umcu7tcoillab/Driverboard/(commit log)

2019-11-21 Changed: Added zener clamping. Small changes.
    [Driverboard_UMCU.csv, Driverboard_UMCU.kicad_pcb, Driverboard_UMCU.sch]
2019-11-21 Changed: starting with malfunction more robust
    [Driverboard_UMCU.kicad_pcb, Driverboard_UMCU.sch, ID_code.sch, SelectToVSwitch.sch]
2019-11-24 Finished v0.1
    [Driverboard_UMCU.kicad_pcb]
2019-11-27 V0.1 ordered. Tidied everything
    [Driverboard_UMCU.kicad_pcb, Driverboard_UMCU.sch, ID_code.sch, Ref_V.sch, SelectToVSwitch.sch]
2019-12-11 Fixed some mistakes of v0.1
    [Driverboard_UMCU.kicad_pcb, Driverboard_UMCU.sch, Ref_V.sch, SelectToVSwitch.sch]
2019-12-19 Fixed: mistakes from v0.1. Added: extra malf pins at Tr connector. Changed: order of pins in TR connector
    [Driverboard_UMCU.kicad_pcb, Driverboard_UMCU.sch, SelectToVSwitch.sch]
2019-12-23 Fixed: better ground paths. Added: license and improved readme.
    [Driverboard_UMCU.csv, Driverboard_UMCU.kicad_pcb, Driverboard_UMCU.sch]
2020-01-07 Changed: Moved some vias. Moved things, for better readability
    [Driverboard_UMCU.kicad_pcb, ID_code.sch]
2020-01-07 Removed: duplicate license file. Fixed: mistake after moved item.
    [Driverboard_UMCU.kicad_pcb]
2020-01-07 Added: local custom made footprints/symbols
    [Driverboard_UMCU.kicad_pcb, Driverboard_UMCU.sch]
2020-01-13 Updated: sheet data. Changed: placed PCB in middle of the sheet
    [Driverboard_UMCU.kicad_pcb, Driverboard_UMCU.sch, ID_code.sch, Ref_V.sch, SelectToVSwitch.sch]
2020-02-26 Changed: Removed unnecessary references in file
    [Driverboard_UMCU.kicad_pcb, Driverboard_UMCU.sch, ID_code.sch, Ref_V.sch, SelectToVSwitch.sch]
2020-03-12 Changed: resistor value
    [SelectToVSwitch.sch]
2020-03-12 Updated: references
    [Driverboard_UMCU.sch, ID_code.sch]
2020-03-12 Changed: voltage ref to use one regulator
    [Driverboard_UMCU.kicad_pcb, Ref_V.sch]
2020-03-13 Updated: zener diode in ID line
    [Driverboard_UMCU.kicad_pcb, Driverboard_UMCU.sch]
2020-03-13 Updated: shunt capacitor
    [ID_code.sch]
2020-03-13 Changed: resistor value for faster switching
    [ID_code.sch]
2020-03-13 Removed: unnecessary C's. Changed: zener diode value in ID line
    [Driverboard_UMCU.kicad_pcb, Driverboard_UMCU.sch]
2020-03-17 Changed: shunt C values
    [Driverboard_UMCU.sch]
2020-03-17 Combined the 2 output connectors into 1
    [Driverboard_UMCU.kicad_pcb, Driverboard_UMCU.sch, ID_code.sch, Ref_V.sch, SelectToVSwitch.sch]
2020-03-18 Changed: small fixes
    [Driverboard_UMCU.kicad_pcb, Driverboard_UMCU.sch]
2020-03-23 Improved: ability to turn off malfunction detection with jumper, previous did not work
    [Driverboard_UMCU.kicad_pcb, Driverboard_UMCU.sch, ID_code.sch]
2020-04-07 switched R22, R23 to be consistent with TR switch part
    [Driverboard_UMCU.kicad_pcb]
2020-04-10 Updated: Worksheet, optimized component values. Added: capacitor on MH to extra speed,
    [Driverboard_UMCU.kicad_pcb, Driverboard_UMCU.sch, ID_code.sch, Ref_V.sch, SelectToVSwitch.sch]
2020-04-17 Optimized component values
    [Driverboard_UMCU.kicad_pcb, Driverboard_UMCU.sch, ID_code.sch, SelectToVSwitch.sch]
2020-04-29 Changed: mosfets to cheaper variants
    [Driverboard_UMCU.kicad_pcb, SelectToVSwitch.sch]
2020-05-20 Changed: symbol table to rescue for distribution. Updated: version nr
    [Driverboard_UMCU.kicad_pcb, Driverboard_UMCU.sch, ID_code.sch, Ref_V.sch, SelectToVSwitch.sch]
